plazomat/Arduino2560_EFI_Input_Shield/Plots/input Shield top view.JPG

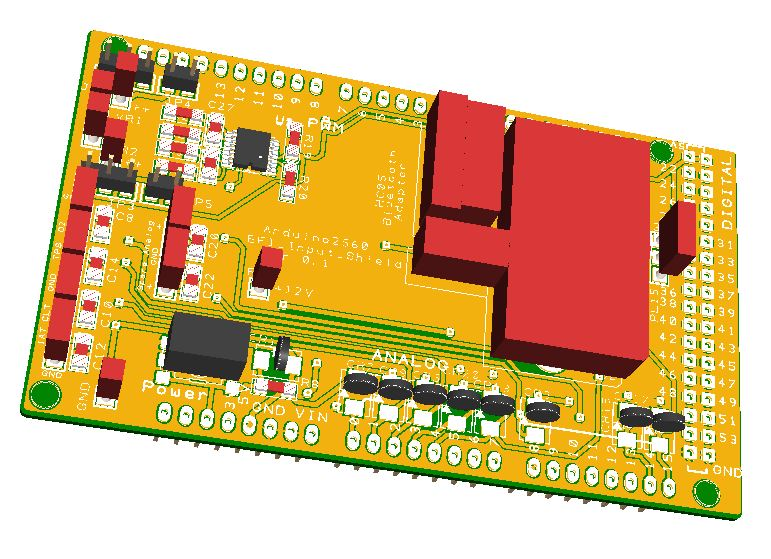
Plots/input Shield top view.JPG
