plazomat/Arduino2560_EFI_Input_Shield/Plots/input Shield bot view.JPG

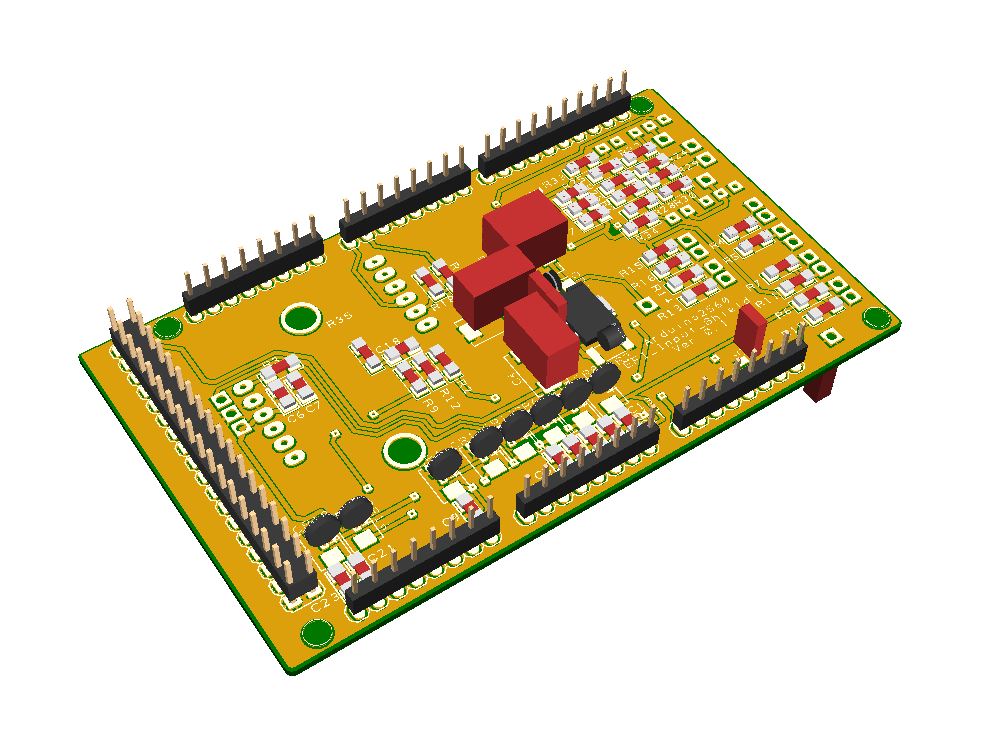
Plots/input Shield bot view.JPG
