plazomat/Arduino2560_EFI_Input_Shield/README.md

Arduino2560_EFI_Input_Shield
============================

Arduino2560_EFI_Input_Shield
Input Shield feature list

Speeduino 0.3 features plus....

Open source SMT Design using DesignSpark PCB
http://www.rs-online.com/designspark/electronics/eng/page/designspark-pcb-home-page

Blue tooth adapter (HC-O5) - for future MS Droid compatibility - should just need to generate a compatible .ini file
http://www.ebay.com/itm/30ft-Wireless-Bluetooth-RF-Transceiver-Module-serial-RS232-TTL-HC-05-for-arduino-/310540196588

On board dual VR Sensor Conditioner (MAX9926 ala jperf module)
http://www.jbperf.com/dual_VR/v2_1.html

Map Sensor on board or provisions for External supplied

2 Spare analog inputs for expansion

Onboard 5V supply for external sensors

All outputs are wire connections to PCB (16 awg) - no common location for connections - simplifies routing and noise performance of Design
Stackable design - using the correct board connectors

Blank PCB's can be ordered from OSH PARK https://oshpark.com/shared_projects/PI4ERPJH about $10 each need to buy 3 pcs
