plazomat/Arduino2560_EFI_Input_Shield/Assy/Bot Assy.JPG

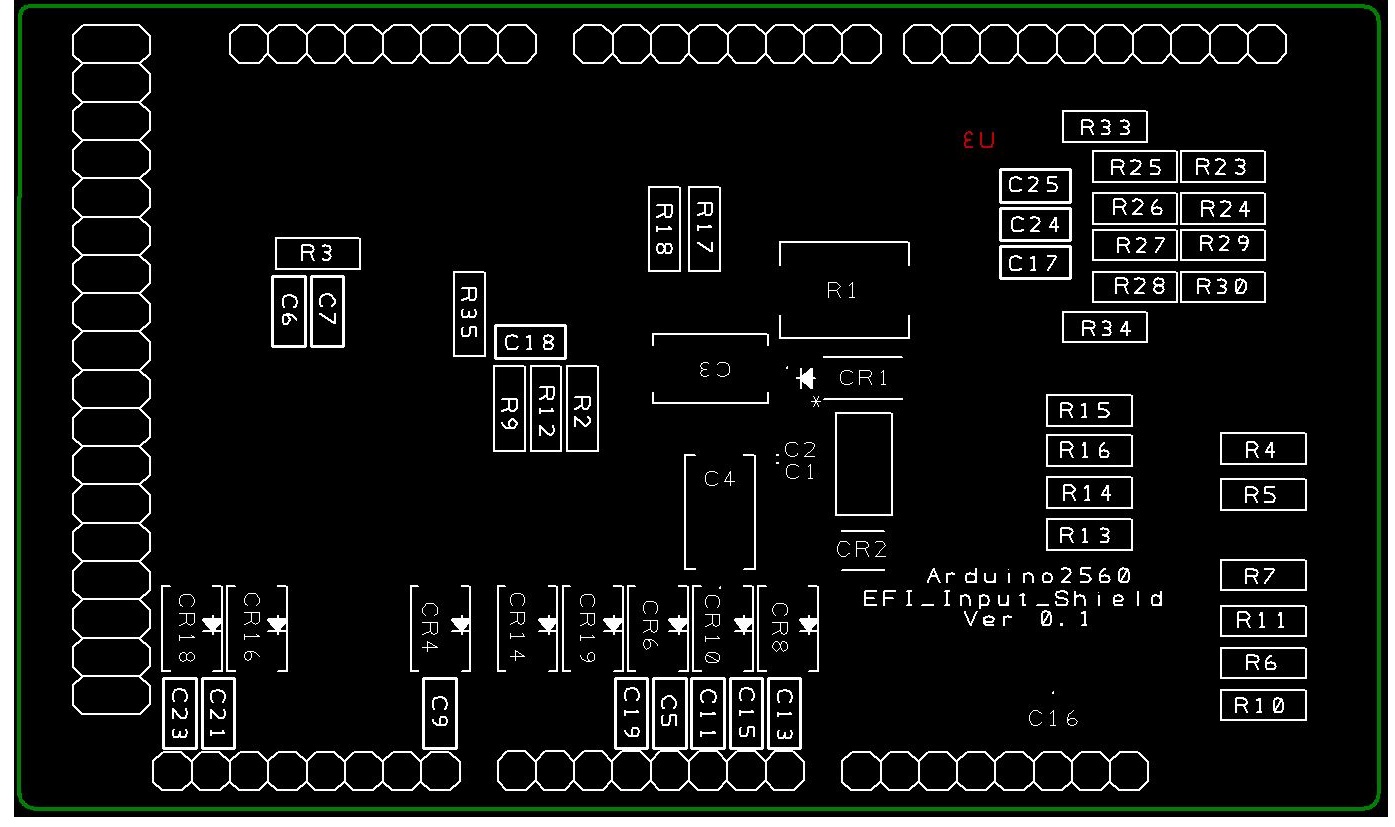
Assy/Bot Assy.JPG
