plazomat/Arduino2560_EFI_Input_Shield/Assy/Top Assy.JPG

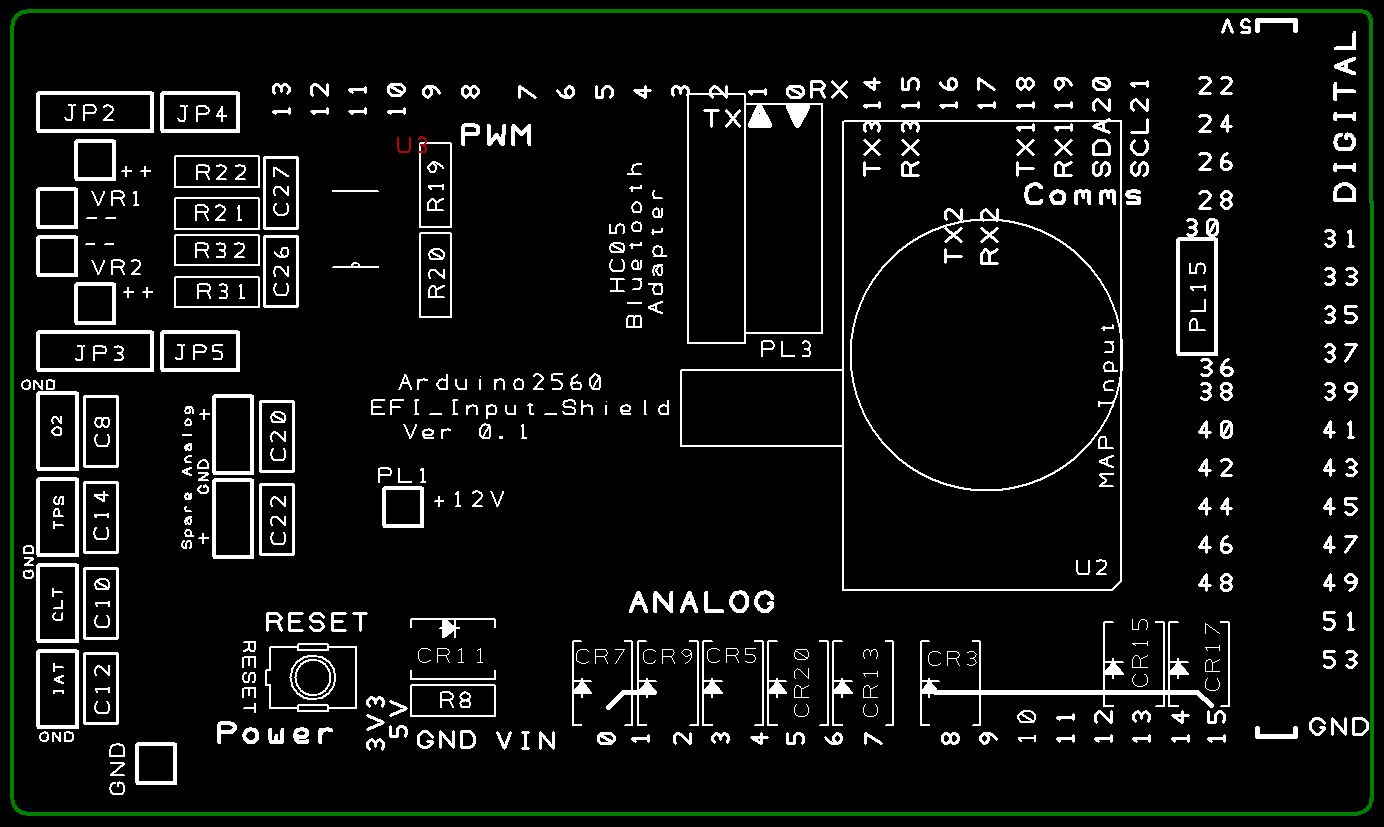
Assy/Top Assy.JPG
