plazomat/Arduino2560_EFI_Input_Shield/(list of files, drawings)

Other design files:
Design Files/Arduino2560_EFI_Input_Shield.pcb
