plazomat/Arduino2560_EFI_Input_Shield/(threads)

Thread 1 (2015-02-04):

Footprint issues with U3 and MAP sensor

plazomat, 2015-02-04:
Just found 2 issues with the input shield. Parts started coming in today and I noticed a couple of things...
1. Footprint for U3 MAX9926U - the VR sensor input is incorrect. It is missing a GND pad under the part for heatsinking and grounding - fix should be pretty easy.

If you need this part you will have to remove the solder mask from the copper pour under U3, tin the area and solder down the part. I will need to fix the layout for the next rev.
1. This one I don't have a permanent fix for yet. The on board MAP sensor will not fit as I intended. I was looking to fold over leads and mount directly to pcb with screws...well leads are not long enough to reach board and if sensor is mounted flat to board then the nipple contacts the board and you can't get a tube on it..

For rev 0.1 I suggest to mount the sensor vertically, if you intend on running it in a car, I am sure you can come up with a way of jumpering or brackets or ?? to make it nice..once my boards come in I will work on an elegant patch..

Closed 2020-12-16.
