plazomat/Arduino2560_EFI_Input_Shield/(commit log)

2015-01-09 Initial commit of design files
    Design files for DesignSpark PCB
    [Arduino2560_EFI_Input_Shield.pcb, Arduino2560_EFI_Input_Shield_pg1.sch, Arduino2560_EFI_Input_Shield_pg2.sch, MEGA_Base Connectors.sch]
2015-01-14 Clean up repo
    [Arduino2560_EFI_Input_Shield.pcb, Arduino2560_EFI_Input_Shield_pg1.sch, Arduino2560_EFI_Input_Shield_pg2.sch, MEGA_Base Connectors.sch]
2015-01-17 Complete Design Package upload - BOM to follow
    Upload of all design files, gerbers, schematics and 3D View
    [Arduino2560_EFI_Input_Shield.pcb, Arduino2560_EFI_Input_Shield_Base Connectors.sch, Arduino2560_EFI_Input_Shield_pg1.sch, Arduino2560_EFI_Input_Shield_pg2.sch]
2015-01-20 BOM Update
    BOM Update - should be final
    [Arduino2560_EFI_Input_Shield (Bill Of Materials).csv]
2015-03-24 BOM Update
    BOM Update with Digikey Part numbers added as much as possible
    [Arduino2560_EFI_Input_Shield (Bill Of Materials).csv]
2015-04-03 Added Assembly type views
    Added Assembly type views showing clear component locations for top and
    bottom sides
